Menadion/EggMinistrator/dashboard/assets-src/login page .png

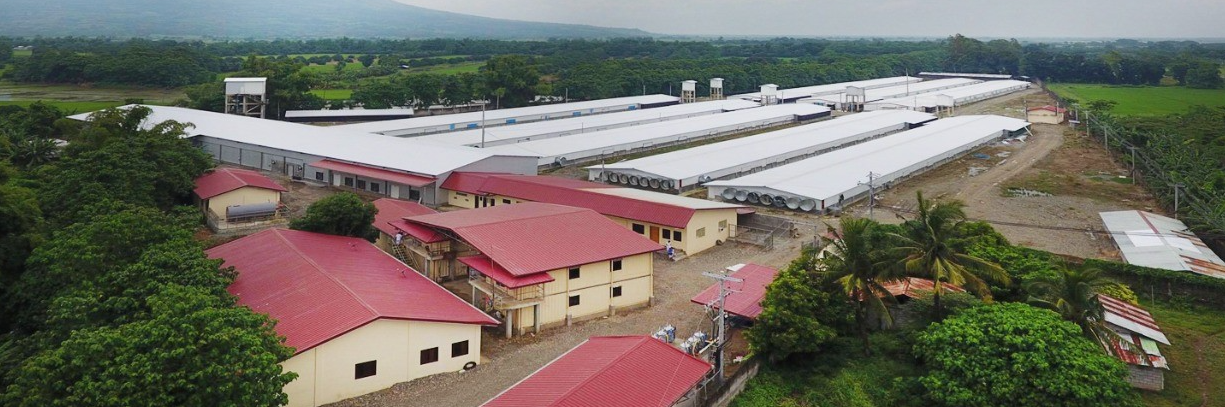
dashboard/assets-src/login page .png
