Menadion/EggMinistrator/firmware/EggMinistrator_ESP32/EggMinistrator_ESP32.ino

/*
  EggMinistrator -- ESP32 firmware (load cell + LCD + LEDs + buzzer only)

  BOARD: ESP32-D0WD-V3 rev v3.1, a CLASSIC ESP32. Confirmed 2026-08-20 by
  running firmware/board-id/ over COM3.

  RENAMED 2026-08-20. This was EggMinistrator_ESP32S3.ino, loose in firmware/.
  Two things were wrong with that. The chip is not an S3, and the Arduino IDE
  requires a .ino to sit inside a folder of the same name -- opening a loose
  sketch makes the IDE offer to move it into a new folder, and it moves ONLY
  the .ino, leaving secrets.h behind and breaking the #include. secrets.h now
  lives in this folder, beside the sketch, where the IDE cannot separate them.

  ⚠️ J: if you already made a secrets.h in firmware/, move it in here.
  ----------------------------------------------------------------------------
  This board does NOT handle the camera. The camera is a regular USB webcam
  plugged into the laptop, which runs ai/inference/classify.py. This board's
  only job is the physical side: read the load cell, send the weight to the
  server, and show whatever verdict comes back on the LCD / LEDs / buzzer.

  The display is a 16x2 character LCD on I2C, NOT the SSD1306 OLED this
  sketch originally targeted. Two lines of sixteen characters is the whole
  canvas -- there is no graphics library and no text sizing.

  THE WEIGHT LEAVES OVER WI-FI, NOT OVER THE USB CABLE. The USB cable
  carries power only, and this is not a style preference: hardware/
  bill-of-materials.md is explicit that a USB *data* path makes this board a
  peripheral attached to a computer, which contradicts the paper's title and
  section 2.2. You can run this board off a power bank across the room and
  it behaves identically. Do not "simplify" it back onto serial.

  NOT COMPILE-TESTED -- I don't have this hardware or an Arduino toolchain
  to verify it on. Grounded in current documentation for the pin
  restrictions and library APIs, but treat it as a first draft to debug on
  real hardware, the way you would any code from any source you haven't
  run yet.

  ============================================================================
  REQUIRED LIBRARIES (Arduino IDE > Sketch > Include Library > Manage
  Libraries):
    - "HX711 Arduino Library" by Bogdan Necula
    - "LiquidCrystal I2C" by Frank de Brabander
    - "ArduinoJson" by Benoit Blanchon (v6.x)
  WiFi.h and HTTPClient.h ship with the esp32 board package -- nothing to
  install. The two Adafruit libraries the OLED needed are no longer required.
  BOARD SELECTION -- GET THIS RIGHT OR THE UPLOAD FAILS:
    Tools > Board > ESP32 Arduino > "ESP32 Dev Module"
                                     ^^^^^^^^^^^^^^^^
    NOT "ESP32S3 Dev Module". This is a classic ESP32-D0WD-V3. Picking the S3
    entry compiles for the wrong chip and the upload will not take. Needs the
    "esp32" board package installed (Boards Manager > search esp32 > Espressif
    Systems).

    Port: Tools > Port > COM3 (that is where board-id found it).
    Everything else can stay on its default. If the upload stalls at
    "Connecting........", hold the BOOT button while it starts.

  ============================================================================
  BEFORE YOU FLASH -- four things, in this order. J, this list is for you.

  1. CHANGE NOTHING ON THE BOARD. Updated 2026-08-23: this sketch now uses
     YOUR pin map, copied from firmware/tester/tester.ino -- HX711 on 32/33,
     buzzer on 4, RGB module on 25 (red), 26 (green), 27 (blue). Your wiring
     is already correct and this step is now a no-op.

     This replaces the old instruction to move LEDs off GPIO12/13 onto
     26/27/23. That is obsolete; you already moved them.

     One rule survives: do NOT put anything back on GPIO12. It is MTDI, and
     if anything holds it HIGH at boot the chip selects a 1.8 V flash voltage
     and may not start at all.

  2. MAKE secrets.h. Copy secrets.h.example to secrets.h in this same folder
     and fill in all five values. It is gitignored, so it does not exist on a
     fresh clone and the sketch will not compile without it. SERVER_HOST is
     the LAN IP of the LAPTOP running the backend, not the board's own IP --
     `ipconfig` on Windows, the IPv4 Address line. DEVICE_KEY must match
     DEVICE_API_KEY in backend/.env exactly or every request comes back 401.
     Never put a real password in THIS file -- CONTRACT.md section 6.

  3. PICK THE RIGHT BOARD. See BOARD SELECTION above. "ESP32 Dev Module".

  4. EXPECT THE LCD TO BE BLANK THE FIRST TIME. LCD_I2C_ADDRESS below is set
     to 0x27, the common PCF8574 address, but a good share of these backpacks
     are 0x3F instead. A wrong address fails SILENTLY -- lit backlight, no
     characters. If that happens, change the one constant and reflash before
     assuming anything else is broken.

  Then: the serial monitor at 115200 is the fastest way to see what it is
  doing. It prints the Wi-Fi join, every weight it reads, and every HTTP
  status it gets back.

  ============================================================================
  PROTOCOL -- see CONTRACT.md section 4.1, which is the authority. Three
  calls, in order:

    1. POST /api/inspections                  { "weight_g": 58.23 }
       -> server creates the row, replies     { "id": 41 }

    2. (the laptop POSTs the classifier output against id 41 -- not us)

    3. GET  /api/inspections/41/result        polled every 500 ms
       -> { "status": "pending" }             until step 2 lands
       -> { "label": "good", "confidence": 0.83 }

    label is one of: good, defective, not_an_egg   (Decision G spelling)

  Every request carries an X-Device-Key header. This board cannot log in as
  a user, so that header is how the server knows it is us.

  Calibrate LOADCELL_CALIBRATION_FACTOR the same way regardless of which
  ESP32 board you use -- see the comment on that constant below.
*/

#include <HX711.h>
#include <Wire.h>
#include <LiquidCrystal_I2C.h>
#include <ArduinoJson.h>
#include <WiFi.h>
#include <HTTPClient.h>

#include "secrets.h"   // WIFI_SSID, WIFI_PASSWORD, SERVER_HOST, SERVER_PORT, DEVICE_KEY

// -----------------------------------------------------------------------
// Pins. REMAPPED 2026-08-15 for a CLASSIC ESP32, not the S3.
//
// The board is an ESP32-D0WD-V3, confirmed by reading it with
// firmware/board-id/board-id.ino rather than from the can, which is marked
// only "ESP32-32X" -- a reseller marking, not an Espressif part number.
//
// The earlier map was written for an ESP32-S3 and four of its pins were
// unusable here: on a classic ESP32, GPIO6 to GPIO11 are wired to the
// integrated SPI flash, and the LCD (8, 9), the buzzer (10) and the red LED
// (11) all sat in that range. Driving them crashes the chip. GPIO12 was also
// a poor choice -- it is MTDI, and held high at boot it selects a 1.8 V flash
// voltage and the board may not start at all.
//
// Avoided on this chip: GPIO6-11 (SPI flash), GPIO0/2/12/15 (strapping),
// GPIO1/3 (UART0, in use by the serial monitor), GPIO34-39 (input only, no
// output driver). GPIO16/17 are also skipped so that this map works unchanged
// on a WROVER module, where those two carry PSRAM.
// ⚠️ REMAPPED 2026-08-23 to match J's board, which is now soldered and cannot
// be changed before the defense. The map below is copied from his working
// bench sketch (firmware/tester/tester.ino), not chosen here.
//
// This SUPERSEDES the 2026-08-20 note that pinned HX711 to 4/5 "because J has
// that wired and reading correctly." That was true on the 20th. He re-wired
// since, and GPIO4 is now his buzzer -- so the old map would have driven the
// buzzer onto the load cell's data line. Confirmed with him directly before
// this edit rather than inferred from the file.
//
// The standing rule that produced the 4/5 entry still holds and produced this
// one too: verified hardware beats a tidier theory. Only the hardware moved.
#define HX711_DT_PIN  32
#define HX711_SCK_PIN 33
#define LCD_SDA_PIN   21   // the classic ESP32 I2C default pair, so stock
#define LCD_SCL_PIN   22   // wiring guides for this board apply as written
#define BUZZER_PIN     4

// 🔴 DESCOPED 2026-08-24, on the team's call, to get the hardware finished in
// time. No buzzer is fitted. Ver9.1's FR-15 asks for "a visual indicator and an
// on-station display", NOT an audible signal, so nothing in the paper is left
// unmet by this.
//
// The calls stay in place rather than being deleted, so wiring one later is a
// single edit here. But beep() BLOCKS: left running with no buzzer it spent
// 120-400 ms per egg waiting on a pin nothing is connected to, out of a 3 s
// per egg budget. Set true only when a buzzer is actually fitted.
#define HAS_BUZZER false
#define LED_RED_PIN   25
#define LED_GREEN_PIN 26
#define LED_BLUE_PIN  27   // WIRED BUT UNUSED since 2026-08-24 -- see indicateResult().
                           // Kept defined so it is still forced LOW at reset;
                           // otherwise a blue left lit by older firmware stays on.

// ✅ Each of the three verdicts keeps its own colour, so FR-15 is satisfied.
//
// FR-15 as Ver9.1 states it: "Indicate the classification result at the
// inspection station through a visual indicator and an on-station display."
// A visual indicator and a display. NOT an audible signal -- an older wording
// of FR-15 said that, and this repo tracked the old one for weeks. The LED and
// the 16x2 LCD satisfy it between them, which is why no buzzer is needed.
//
// ⚠️ CHANGED 2026-08-23: this is ONE RGB LED module on 25/26/27, not three
// discrete LEDs.
//
// ⚠️ CHANGED 2026-08-24: "not an egg" is ORANGE, not blue, on J's
// recommendation. The module has no orange pin -- pin 27 is never driven HIGH
// in either sketch -- so orange is RED full plus GREEN at partial brightness.
// The recipe is copied exactly from J's bench sketch (tester.ino:538-541,
// analogWrite(GREEN_LED, 80)), which is the version proven on the actual board.
// Full green instead of 80 gives yellow, not orange.
//
// GREEN is driven through analogWrite EVERYWHERE below, never digitalWrite.
// Mixing the two on one pin means analogWrite attaches an LEDC channel and a
// later digitalWrite may or may not detach it, depending on core version. One
// mode for that pin removes the question entirely. RED is never PWM'd, so it
// stays digitalWrite.

// The GPIO12/13 warning that stood here is retired: J's LEDs are no longer on
// those pins. Keeping the reason on record because it still constrains any
// future remap -- GPIO12 is MTDI, and held HIGH at boot it selects a 1.8 V
// flash voltage and the board may not start at all. Do not put anything back
// on 12.

// HX711 calibration factor -- MUST be calibrated for your specific load
// cell, the same procedure regardless of which ESP32 board drives it:
//   1. Flash a minimal sketch that prints scale.get_units(10) in a loop
//      with nothing on the platform, right after scale.tare().
//   2. Place a known weight (anything you can weigh precisely elsewhere)
//      and note the raw reading.
//   3. LOADCELL_CALIBRATION_FACTOR = raw_reading / known_weight_grams
//   4. Re-flash with that value; confirm get_units() reports correctly
//      for a couple of different test weights before trusting it.
// ✅ 2026-08-16, J: raw difference of 503206 - 458939 = 44267 counts for a
// known 60 g weight, giving 44267 / 60 = 737.8; he settled on 735.25 in
// testing, and an egg then read 58.6 g -- a plausible egg, not a coincidence.
//
// ⚠️ CHANGED 2026-08-23 to 698.0, taken from J's bench sketch
// (firmware/tester/tester.ino), on M's ruling that the station follows the
// number on the board J is actually running.
//
// The two numbers disagree by 5.3%, which is ~3 g on a 60 g egg -- THREE TIMES
// the 1 g tolerance (CONTRACT.md section 4, settled 2026-08-24 to match the
// paper's Table 9; the repo previously said +/-2 g, which made the same gap
// look like 1.5x). Only one of them can describe this assembly. 698.0 is
// adopted because it is the more recent of the two and the bench rig is the
// one physically wired, NOT because it was re-derived -- nobody has re-run the
// four steps above since the 16th.
//
// Tare matters as much as the factor at 1 g: tare(20) runs once in setup() and
// never again, so anything on the plate at power-up becomes zero for the whole
// session. Power up with the holder fitted and the plate empty.
//
// 🔴 OWED: re-run the calibration once the egg holder is final and delete the
// loser. The factor describes the whole mechanical assembly, not just the
// cell, so adding the holder invalidates both figures anyway.
float LOADCELL_CALIBRATION_FACTOR = 698.0;

const float EGG_PRESENT_THRESHOLD_G = 20.0;
const float EGG_REMOVED_THRESHOLD_G = 15.0;
const unsigned long WEIGHT_SEND_INTERVAL_MS = 300;

HX711 scale;

// 0x27 is the usual address for the PCF8574 backpack on these modules; a
// good number of them are 0x3F instead. If the screen stays blank but the
// backlight is on, that is the first thing to try. An I2C scanner sketch
// settles it in a minute.
#define LCD_I2C_ADDRESS 0x27
LiquidCrystal_I2C lcd(LCD_I2C_ADDRESS, 16, 2);

// Declared up here, before handleResult() and showResult() use it. It was
// originally defined further down the file, after its first use, which does
// not compile in C++ -- and the Arduino IDE's auto-generated prototypes make
// it worse, since they reference the type before it exists.
struct InspectionResultLocal {
  String label;
  float confidence;
};

unsigned long lastWeightSend = 0;
bool waitingForResult = false;
unsigned long resultRequestedAt = 0;
// RAISED 5000 -> 15000 on 2026-08-25. The old budget was shorter than the
// pipeline it was waiting on, so the board declared "No response" while the
// verdict was still in flight. It then landed in the database anyway, leaving
// the LCD and the dashboard disagreeing about the same egg. The board polls
// every 500 ms, so a longer ceiling costs nothing when the verdict is quick.
const unsigned long RESULT_TIMEOUT_MS = 15000;  // give up waiting and go back to idle

long currentInspectionId = -1;                  // handed back by step 1
unsigned long lastPoll = 0;
const unsigned long POLL_INTERVAL_MS = 500;

// A hard ceiling on the "wait for the operator to take the egg off" loop.
// Without it a drifting load cell or an egg nobody removes hangs the board
// forever with no way out but the reset button.
const unsigned long REMOVAL_TIMEOUT_MS = 30000;

// ---------------------------------------------------------------------------
String baseUrl() {
  return String("http://") + SERVER_HOST + ":" + String(SERVER_PORT);
}

// ---------------------------------------------------------------------------
// Bounded, so a wrong password shows an error instead of hanging in setup().
bool connectWifi(unsigned long timeoutMs) {
  if (WiFi.status() == WL_CONNECTED) return true;

  WiFi.mode(WIFI_STA);
  WiFi.begin(WIFI_SSID, WIFI_PASSWORD);

  unsigned long start = millis();
  while (WiFi.status() != WL_CONNECTED && millis() - start < timeoutMs) {
    delay(250);
  }
  return WiFi.status() == WL_CONNECTED;
}

// ---------------------------------------------------------------------------
void setup() {
  Serial.begin(115200);   // kept for debugging and load cell calibration only
  pinMode(BUZZER_PIN, OUTPUT);
  pinMode(LED_RED_PIN, OUTPUT);
  pinMode(LED_GREEN_PIN, OUTPUT);
  pinMode(LED_BLUE_PIN, OUTPUT);
  digitalWrite(BUZZER_PIN, LOW);
  digitalWrite(LED_RED_PIN, LOW);
  analogWrite(LED_GREEN_PIN, 0);   // one mode for this pin, everywhere
  digitalWrite(LED_BLUE_PIN, LOW);

  Wire.begin(LCD_SDA_PIN, LCD_SCL_PIN);
  // Unlike the OLED's begin(), LiquidCrystal_I2C::init() reports nothing back,
  // so a wrong address fails silently -- blank screen, lit backlight. See the
  // note on LCD_I2C_ADDRESS above.
  lcd.init();
  lcd.backlight();
  showMessage("Starting...");

  showMessage("Connecting WiFi");
  if (connectWifi(20000)) {
    Serial.print("Wi-Fi connected, IP ");
    Serial.println(WiFi.localIP());
  } else {
    Serial.println("Wi-Fi FAILED -- check secrets.h");
    showMessage("WiFi failed\nCheck secrets.h");
    beepError();
  }

  scale.begin(HX711_DT_PIN, HX711_SCK_PIN);

  // Taken from J's bench sketch, and it fixes a real defect here. tare() calls
  // wait_ready() internally, which spins until the HX711's DOUT pin goes low.
  // With the amplifier unwired or on the wrong pins that never happens and
  // setup() hangs forever -- no serial past this point, no HTTP, nothing. It
  // reads as a dead board rather than a wiring fault. Ask first, with a bound.
  if (!scale.wait_ready_timeout(3000)) {
    Serial.println("ERROR: HX711 not responding -- check DT/SCK wiring and power");
    showMessage("HX711 error\nCheck wiring");
    beepError();
    // Deliberately does not continue. Every weight from here would be garbage,
    // and a station silently reporting nonsense is worse than one that stops.
    while (true) delay(1000);
  }

  scale.set_scale(LOADCELL_CALIBRATION_FACTOR);

  showMessage("Taring...\nEmpty the plate");
  delay(2000);      // give the operator a moment to take anything off
  scale.tare(20);   // 20 readings rather than the default; steadier zero

  showMessage("Ready.\nPlace an egg.");
}

// ---------------------------------------------------------------------------
float readWeightGrams() {
  if (!scale.is_ready()) return 0.0;
  return scale.get_units(5);
}

// ---------------------------------------------------------------------------
// The weight that actually gets sent. A single get_units() reading taken the
// instant an egg lands is still settling, so this waits for the mechanical
// bounce to die down and then averages. From J's bench sketch, where it was
// the difference between a stable number and one that drifted a gram either
// way while you watched it.
float settledWeightGrams() {
  delay(800);   // let the egg stop rocking before measuring anything

  const int readings = 20;
  float total = 0;
  for (int i = 0; i < readings; i++) {
    float grams = scale.get_units(1);
    if (grams < 0) grams = 0;   // a hair below zero is noise, not a negative egg
    total += grams;
    delay(30);
  }
  return total / readings;
}

// ---------------------------------------------------------------------------
// ⚠️ TEMPORARY, AND IT IS A SECOND COPY OF SOMETHING THE SERVER OWNS.
//
// Size grading belongs to the server: CONTRACT decision 4, implemented by
// findSizeGrade() against the size_grades table. This exists only so the board
// can show something useful on the LCD while running standalone on the bench,
// before the laptop half of section 4.1 exists.
//
// DELETE THIS the moment the board is getting real verdicts back from the
// server. Two copies of a grading rule is two rules, and the one on the LCD
// will eventually disagree with the one on the dashboard in front of somebody.
//
// The bands are PNS/BAFS 321:2021, matching database/sample-data.sql exactly.
// J's bench sketch used the USDA sizes instead (Small 42.52, Medium 49.61,
// Large 56.70, X-Large 63.79, Jumbo 70.87), which is a different national
// standard: a 58.6 g egg is Medium under PNS and Large under USDA. The paper
// cites PNS, so PNS wins here.
String localSizeGrade(float grams) {
  if (grams <  45.0) return "Pewee";
  if (grams <  55.0) return "Small";
  if (grams <  60.0) return "Medium";
  if (grams <  65.0) return "Large";
  if (grams <  70.0) return "Extra Large";
  return "Jumbo";
}

// ---------------------------------------------------------------------------
// Step 1. Returns true and sets currentInspectionId, or false on any failure.
bool postWeight(float grams) {
  if (!connectWifi(5000)) return false;

  HTTPClient http;
  http.begin(baseUrl() + "/api/inspections");
  http.addHeader("Content-Type", "application/json");
  http.addHeader("X-Device-Key", DEVICE_KEY);

  StaticJsonDocument<96> body;
  body["weight_g"] = grams;
  String payload;
  serializeJson(body, payload);

  int code = http.POST(payload);
  if (code != 200 && code != 201) {
    Serial.print("POST /api/inspections failed, HTTP ");
    Serial.println(code);
    http.end();
    return false;
  }

  StaticJsonDocument<128> reply;
  DeserializationError err = deserializeJson(reply, http.getString());
  http.end();
  if (err || !reply.containsKey("id")) {
    Serial.println("POST /api/inspections: no id in reply");
    return false;
  }

  currentInspectionId = reply["id"].as<long>();
  Serial.print("inspection id ");
  Serial.println(currentInspectionId);
  return true;
}

// ---------------------------------------------------------------------------
// Step 3. Asks once. Returns true only when a real verdict came back.
bool pollForResult(InspectionResultLocal &out) {
  if (currentInspectionId < 0) return false;
  if (WiFi.status() != WL_CONNECTED) return false;

  HTTPClient http;
  http.begin(baseUrl() + "/api/inspections/" + String(currentInspectionId) + "/result");
  http.addHeader("X-Device-Key", DEVICE_KEY);

  int code = http.GET();
  if (code != 200) {
    http.end();
    return false;
  }

  StaticJsonDocument<192> reply;
  DeserializationError err = deserializeJson(reply, http.getString());
  http.end();
  if (err) return false;

  // Still waiting on the laptop's classification -- not an error.
  if (!reply.containsKey("label")) return false;

  out.label = reply["label"].as<String>();
  out.confidence = reply["confidence"] | 0.0f;
  return true;
}

// ---------------------------------------------------------------------------
// Bounded wait for the operator to lift the egg off the platform. Bails out
// after REMOVAL_TIMEOUT_MS rather than blocking the board indefinitely.
void waitForEggRemoval() {
  unsigned long start = millis();
  while (readWeightGrams() > EGG_REMOVED_THRESHOLD_G) {
    if (millis() - start > REMOVAL_TIMEOUT_MS) {
      Serial.println("egg never removed -- giving up and re-arming");
      break;
    }
    delay(200);
  }
  digitalWrite(LED_RED_PIN, LOW);
  analogWrite(LED_GREEN_PIN, 0);   // NOT digitalWrite -- see indicateResult()
  digitalWrite(LED_BLUE_PIN, LOW);
  showMessage("Ready.\nPlace an egg.");
}

// ---------------------------------------------------------------------------
void handleResult(const InspectionResultLocal &result) {
  showResult(result);
  indicateResult(result);
  waitingForResult = false;
  currentInspectionId = -1;
  waitForEggRemoval();
}

// ---------------------------------------------------------------------------
void loop() {
  float weight = readWeightGrams();
  unsigned long now = millis();

  if (waitingForResult) {
    if (now - resultRequestedAt > RESULT_TIMEOUT_MS) {
      // The server never produced a verdict (laptop app not running? egg not
      // detected in frame?) -- don't leave the operator staring at a stale
      // "Sending weight" forever.
      showMessage("No response.\nTry again.");
      beepError();
      waitingForResult = false;
      currentInspectionId = -1;
      return;
    }

    if (now - lastPoll > POLL_INTERVAL_MS) {
      lastPoll = now;
      InspectionResultLocal result;
      if (pollForResult(result)) {
        handleResult(result);
      }
    }
    return;   // don't send more weight readings mid-inspection
  }

  if (weight < EGG_PRESENT_THRESHOLD_G) {
    delay(150);
    return;   // nothing on the platform yet
  }

  // An egg just showed up: settle, measure properly, then send.
  if (now - lastWeightSend > WEIGHT_SEND_INTERVAL_MS) {
    showMessage("Egg detected.\nMeasuring...");
    lastWeightSend = now;

    // The trigger reading above only had to clear a 20 g threshold. It is not
    // the measurement -- the egg is still settling when it crosses that line.
    // This is the number that goes in the database and drives the size grade,
    // so it is worth the extra second.
    float finalWeight = settledWeightGrams();

    // Bench aid only: shows a grade before the server has answered. Goes away
    // with localSizeGrade() once the laptop half of section 4.1 exists.
    Serial.print("Final weight: ");
    Serial.print(finalWeight, 2);
    Serial.print(" g, local grade ");
    Serial.println(localSizeGrade(finalWeight));

    showMessage("Sending weight");

    if (postWeight(finalWeight)) {
      waitingForResult = true;
      resultRequestedAt = now;
      lastPoll = now;
    } else {
      showMessage("Server error\nTry again.");
      beepError();
    }
  }
}

// ---------------------------------------------------------------------------
// Every message is at most two lines of sixteen characters. Call sites keep
// the original "\n" convention and this splits on it, so the message strings
// elsewhere in the file did not have to change.
//
// Anything past column 16 is CUT, not wrapped. A character LCD wraps a long
// line onto whichever row it feels like -- on many 16x2 modules row 0
// continues into row 2 of a 4-line address space, which shows up as nothing
// at all. Truncating is ugly on purpose; silent disappearance is worse.
void showMessage(const String &msg) {
  int split = msg.indexOf('\n');
  String top    = (split < 0) ? msg : msg.substring(0, split);
  String bottom = (split < 0) ? ""  : msg.substring(split + 1);

  lcd.clear();
  lcd.setCursor(0, 0);
  lcd.print(top.substring(0, 16));
  lcd.setCursor(0, 1);
  lcd.print(bottom.substring(0, 16));
}

// Verdict on the top row, confidence underneath. The longest label we can
// receive is "not_an_egg" at 10 characters, so it fits without truncating.
void showResult(const InspectionResultLocal &result) {
  lcd.clear();
  lcd.setCursor(0, 0);
  lcd.print(result.label.substring(0, 16));
  lcd.setCursor(0, 1);
  lcd.print("Conf: ");
  lcd.print(result.confidence * 100.0, 0);
  lcd.print("%");
}

// ---------------------------------------------------------------------------
// FR-15: "Indicate the classification result at the inspection station
// through a visual indicator and an on-station display." (Ver9.1 wording. An
// earlier version said "an audible signal", which is why beep() exists below.)
void indicateResult(const InspectionResultLocal &result) {
  digitalWrite(LED_RED_PIN, LOW);
  analogWrite(LED_GREEN_PIN, 0);
  digitalWrite(LED_BLUE_PIN, LOW);

  if (result.label == "good") {
    analogWrite(LED_GREEN_PIN, 255);
    beep(1, 120);
  } else if (result.label == "defective") {
    digitalWrite(LED_RED_PIN, HIGH);
    beep(2, 120);
  } else {
    // "not an egg" -- ORANGE: red full, green partial. Same values as J's
    // bench sketch. Steady rather than blinking, so it reads as a verdict
    // rather than as an error state.
    digitalWrite(LED_RED_PIN, HIGH);
    analogWrite(LED_GREEN_PIN, 80);
    beep(3, 80);
  }
}

void beep(int times, int durationMs) {
  if (!HAS_BUZZER) return;   // no buzzer fitted: do not burn the delay
  for (int i = 0; i < times; i++) {
    digitalWrite(BUZZER_PIN, HIGH);
    delay(durationMs);
    digitalWrite(BUZZER_PIN, LOW);
    if (i < times - 1) delay(durationMs);
  }
}

void beepError() {
  if (!HAS_BUZZER) return;
  digitalWrite(BUZZER_PIN, HIGH);
  delay(500);
  digitalWrite(BUZZER_PIN, LOW);
}
