Menadion/EggMinistrator/(commit log)

2026-07-27 docs: sync READMEs to the single-candling design, add BOM
    The READMEs were written in the initial scaffold, before the group meeting
    settled the capture on one candling frame. They still described a two-photo
    rig and promised dirt/discoloration detection the system cannot do.
    - README: one capture, three kinds of finding (quality / shell / balut routing)
    - ai: dataset classes no longer list dirty/discolored; note that no dataset is
    inherited; single-model accuracy field
    - firmware: document that the ESP32-CAM has no USB port and needs an FTDI or
    ESP32-CAM-MB to flash at all
    - hardware: two-wave purchase plan; enclosure is a commissioned 3D print, with
    what a print shop needs from us
    -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
2026-07-28 docs: align repo docs with Ver4 (balut descoped), flag stack mismatch
    Ver4 removed balut/embryo routing from both scope sections. Strip it from
    the repo docs and pin the AI class list to what Ver4 s3.2.6 actually names.
    - README.md: drop the Routing row; two kinds of finding, not three.
    - ai/README.md: no embryo class. Dataset classes pinned to s3.2.6 wording
    (good, blood-meat-spot, large-crack, gross-shell-damage).
    - CONTRIBUTING.md: scope note updated; dashboard verification is now
    npm run build, not php -l.
    Also flags an unresolved contradiction the merge exposed: the paper says
    the dashboard is PHP + XAMPP, the merged dashboard/ is React + Vite with
    no PHP. Noted in README.md and C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
2026-07-28 docs: add FR-04 size classification spec (PNS/BAFS 321:2021)
    FR-04 said "assign a size class based on measured weight" with no table
    behind it. sample-data.sql implemented 5 grades with invented boundaries;
    mockData.js implemented 6 with different ones. Neither matched a standard.
    Pins the grades to PNS/BAFS 321:2021 and gives Ricardo the replacement
    seed data plus the lookup query. Boundaries restated as half-open ranges
    so decimal load-cell readings can't fall between two classes.
    Flags three items still to verify against the standard itself: whether it
    defines six classes or seven (the seventh is likely duck), the "Pewee"
    spelling, and the whole-gram band phrasing.
2026-07-28 docs: settle dashboard stack in favour of React, update BOM
    Decision E: the paper is corrected to name React + Vite rather than
    rebuilding the dashboard in PHP 13 days out. MySQL and XAMPP stay.
    - README.md, CONTRIBUTING.md: unresolved-contradiction warnings replaced
    with the decision and its rationale.
    - bill-of-materials.md: "already owned" row split so PHP no longer
    appears as the stack. Zero-cost claim is unaffected since Node, React
    and Vite are free as well.
2026-07-30 docs: pin the classifier output spec, fix BOM stack, supersede DIRTY
    The paper settled the classifier's output on 2026-07-30 (Decision G): the model
    emits three classes, good / defective / not_an_egg. It returns one verdict per
    egg and does not report which defect it found.
    ai/README.md: the class list was an unfilled comment blocking the labelling
    protocol and the database schema. Now specified, with the reasoning. Softmax
    scores sum to 1, so a per-defect list cannot represent an egg with two defects
    at once; more decisively, blood and meat spots cannot be sourced on demand, so
    splitting the scarcest images across several classes is the worst option
    available to this dataset. not_an_egg is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
2026-08-02 feat(ai): open and resize the image, guard the failure path
    classify.py now reads the file it was named after, forces it to a fixed
    224x224, and still emits the unchanged three-field contract.
    cv2.imread returns None on an unreadable path rather than raising, so the
    failure surfaced one line later at resize with an assertion error that
    mentions nothing about files. The guard catches it at the point it happens
    and exits nonzero with the path on stderr, printing no JSON line.
    A missing file is not a not_an_egg. That class is a verdict about what the
    camera saw; an unreadable path means nothing was observed at all. Emitting
    one would write a false observation into ai_assessments, corrupt the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
2026-08-06 feat(ai): train a real model from the dataset folders
    train.py reads ai/dataset/, holds back 20% for validation, and fits a
    2,562-parameter head on a frozen MobileNetV2 base. It saves egg.keras
    and classes.json from the same run, so the class order travels with the
    weights it describes.
    Keras assigns class indices alphabetically, which means adding a folder
    silently renumbers the classes already there. Nothing hardcodes the
    list; check_order.py prints the order Keras actually assigned.
2026-08-06 feat(ai): classify from the trained model instead of a hardcoded verdict
    classify.py loads egg.keras and classes.json, runs the image through the
    model, and reports the winning class with its score. The class list is
    read from disk rather than restated in the source, so it cannot drift
    away from the model that produced it.
    Converts BGR to RGB before predicting. cv2.imread returns BGR while
    image_dataset_from_directory reads RGB, so training and inference
    disagreed on channel order and nothing raised an error. On the sample
    image the correction moved confidence from 0.58 to 0.74.
2026-08-09 feat(ai): track the dataset class folders, add the collection guide
    The three class folders under ai/dataset/ are now committed empty via .gitkeep, so
    anyone who clones gets the exact class names. The folder name IS the class string that
    train.py reads and classify.py prints, so a typo or a rename silently changes what the
    system reports. Tracking the folders removes the chance to get it wrong.
    .gitignore now ignores dataset contents rather than the dataset folder itself. The
    negations come last because the last matching rule wins.
    Adds how-to-add-images.md, the shooting and training guide for whoever collects photos,
    and requirements.txt pinned to the versions the model was trained with.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
2026-08-09 docs: propagate the hardware descope and sync the docs with shipped code
    Two sets of changes, both catching the documentation up to reality.
    The 2026-08-07 hardware descope: the ESP32-CAM is out of the build. Capture is a USB
    webcam on the laptop and the already-owned ESP32-S3 is repurposed from programmer to
    networked weight node, reading the HX711 and posting over Wi-Fi. That Wi-Fi hop is what
    keeps the IoT claim in the paper title true, so firmware/README.md now says explicitly
    not to wire it over USB serial instead. bill-of-materials.md is rebuilt around the new
    parts list with real figures. Shell colour corrected to white and tinted throughout;
    brown was never sourced.
    ai/README.md ha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
2026-08-13 feat(ai): stamp the model version at training time
    model_version is NOT NULL on main since the merge, and classify.py emitted
    only three fields, so no assessment row could be inserted at all.
    train.py now writes ai/models/version.json in the same run that saves the
    weights, as MODEL_VERSION plus a UTC stamp (0.3.0+20260813T144500Z). Written
    alongside model.save() on purpose: a version typed by hand is a sticker you
    can forget to peel off, and the database would record a string describing
    weights nobody has. Same reasoning as classes.json.
    classify.py reads it, times the prediction, and emits six fields instead of
    three: +model_name, +model_version, +inference_time_ms.
    version.json is giti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
2026-08-13 docs: settle not_an_egg, record the merge
    Decision 8: a not_an_egg scan is recorded, not discarded. Misload rate is
    real diagnostic data about the station. The proposal to write nothing and
    only warn on screen is declined.
    The flood behind that proposal was real but is already fixed at the source:
    inspectionService.js:33 filters final_disposition <> no_egg, that endpoint is
    the only path any page has to inspection rows, and the schema.sql:202 view
    filters the same way. Misload rows are write-only. A UI guard written for
    this was reverted the same day - it guarded a door the SQL already locks.
    Records the open consequence: AnalyticsPage.jsx:134 counts not_an_egg from
    rows the API already st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
2026-08-13 fix(dashboard): recompute the history filter when the fetch lands
    useMemo was missing historyScans from its dependency array, so filtered was
    computed once against the empty starting array and never recalculated when
    the request returned. History sat on "No inspections match your filters"
    until you touched a dropdown.
    Found while investigating the misload flood; unrelated to it.
2026-08-13 docs: settle raw_result, store the classifier's line verbatim
    raw_result holds the full JSON line classify.py printed, stored character for
    character. Not a re-serialised copy: parsing and re-dumping reorders keys and
    changes spacing, and the value of the column is that it is the classifier's
    own output rather than a version of it.
    Every other column in ai_assessments is written by the insert code.
    raw_result is the only value in the row that arrives untouched, so when a
    stored result looks wrong it answers whether the model said it or the insert
    changed it, without re-running the pipeline. The six emitted fields also land
    in two tables - five columns in ai_assessments, image in inspection_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
2026-08-13 feat(firmware): take J's ESP32-S3 sketch, fix the type-before-use error
    Written by J, cherry-picked from origin/Jasfer 23a449a. It was sitting in
    hardware/Pyhton yolo/ alongside a parallel YOLO pipeline; only this file
    comes across, and it lands in firmware/ where section 2 says ESP32 firmware
    belongs. Nothing else from that branch is taken - see CONTRACT.md section 7.
    Why this file and not the rest: it is the only one that matches the current
    design. No camera on the board, USB webcam on the laptop, and three result
    states including not_an_egg, so it agrees with settled decision 8. The
    branch's data.yaml classifies good / cracked-damaged / blood-meat-spot,
    which result_label cannot store.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
    [EggMinistrator_ESP32S3.ino]
2026-08-13 docs: specify the station-to-server seam, close the last TO FILL
    Section 4.1 still described the ESP32 sending a candling image, which was
    the ESP32-CAM design. Since the 2026-08-07 descope the board sends weight
    only; the camera is a USB webcam on the laptop.
    Transport is HTTP over Wi-Fi. The board's USB cable carries power, not data:
    bill-of-materials.md is explicit that a USB data path makes the board a
    peripheral attached to a computer, which contradicts the paper's title and
    section 2.2.
    Three calls, in order. The board POSTs weight and the server mints the
    egg_inspections row and returns its id; the laptop POSTs the six classifier
    fields against that id; the board polls for the verdi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
2026-08-13 feat(firmware): drive the 16x2 LCD instead of the SSD1306 OLED
    The station display is a pre-owned 16x2 I2C character LCD, confirmed by J on
    2026-08-13. The sketch targeted a 128x64 SSD1306, so this is a library and an
    API change, not a rename: Adafruit_SSD1306 and Adafruit_GFX are dropped for
    LiquidCrystal_I2C, and there is no graphics context, no text sizing and no
    pixel cursor to work with.
    showMessage() keeps the original "\n" convention and splits on it, so every
    call site elsewhere in the file is unchanged. It truncates at column 16 by
    design: a character LCD given a too-long line wraps it into whichever row the
    controller's address map says comes next, which on many 16x2 modules is no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
2026-08-13 feat(firmware): post weight over Wi-Fi, add a stub server to test against
    Implements the three calls in CONTRACT.md section 4.1. The board POSTs its
    weight, the server mints the egg_inspections row and returns the id, and the
    board polls that id every 500ms until a verdict exists, then drives the LCD,
    LEDs and buzzer per FR-15.
    The USB cable now carries power only. bill-of-materials.md is explicit that a
    USB data path makes this board a peripheral attached to a computer, which
    contradicts the paper's title and section 2.2, so the sketch says so at the
    top where someone tempted to simplify it back to serial will read it.
    readSerialCommands() and handleLine() are gone with the serial protoco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
    [EggMinistrator_ESP32S3.ino, stub_server.py]
2026-08-13 fix(backend): override writes final_disposition, not final_grade (FR-03 verified)
    [stub_server.py]
2026-08-13 docs: pin the owed paper revisions, correct the dataset collection constraint
2026-08-14 docs: load cell and HX711 arrived, calibration is the next hardware job
2026-08-15 feat(backend): open a daily batch so station rows get readable egg IDs
    createInspection left batch_id and sequence_number null, so formatEggId fell
    back to a truncated UUID and every station-created row read as 78919cdf...
    next to the seeded B001-EGG-001 rows.
    A batch is now one day's inspection run at one station. The first egg of the
    day opens it, the rest join it, and sequence_number restarts at 1 each day.
    Chosen over an operator-started batch because the station has no screen to
    open and close one by hand; explicit sessions stay as future work, which is
    what started_at and completed_at were designed for.
    Two details that are load-bearing rather than stylistic:
    - The date comes from C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
2026-08-15 fix(firmware): remap pins for a classic ESP32, four sat on the flash bus
    The board is an ESP32-D0WD-V3, not an ESP32-S3. Confirmed by reading the chip
    rather than the can, which carries only "ESP32-32X" -- a reseller marking with
    no Espressif part behind it.
    The pin map was written for an S3 and was unsafe here. On a classic ESP32
    GPIO6 to GPIO11 are wired to the integrated SPI flash, and the LCD (8, 9),
    the buzzer (10) and the red LED (11) all sat inside that range; driving them
    crashes the chip. GPIO12 was also poor -- it is MTDI, and held high at boot it
    selects 1.8 V flash and the board may not start.
    HX711 DT 4 -> 32 buzzer 10 -> 25
    HX711 SCK 5 -> 33 LED red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
    [EggMinistrator_ESP32S3.ino, board-id.ino]
2026-08-16 feat(firmware): adopt J's verified hardware layer, keep the network architecture
    J's bench sketch is the ground truth for what actually works on the board, so
    the hardware half comes from it wholesale. The architecture does not.
    Taken from his file:
    - HX711 back on pins 4/5. An earlier pass moved them to 32/33 on paper;
    his is wired and reading correctly, and both pins are fine on a classic
    ESP32. Verified hardware beats a tidier theory.
    - Calibration factor 735.25, measured against a known 60 g weight. Replaces
    the library placeholder 2280.0, which made every reading meaningless.
    - wait_ready_timeout(3000) before tare, which fixes a real defect here:
    tare() spins fore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
    [EggMinistrator_ESP32S3.ino]
2026-08-18 fix(database): staff_overrides accepts no_egg (audit item 1)
    previous_disposition and new_disposition carried three values while
    egg_inspections has carried four since Decision G. An inspector correcting a
    wrong no_egg verdict had no legal value for the state being corrected away
    from, so the override row could not insert.
    Both columns widened, not just previous_disposition: staff may also need to
    mark a capture as containing no egg when the model got it the other way round.
    Latent, not live -- overrideInspection() writes egg_inspections and has never
    inserted into staff_overrides. Wiring that up is a separate question; the
    schema can now accept the write.
2026-08-18 docs(contract): staff_overrides is not empty, it holds one seeded row
    Correcting item 7 against the live local database. sample-data.sql:50 seeds a
    single override row dated 2026-07-25, so the table is not empty -- and the
    seeded row is the sharper problem. An empty table reads as "not built yet".
    One plausible hand-written row reads as working until someone checks that the
    count does not move when you override an egg on the projector.
    No application code path writes the table; that part stands.
2026-08-20 feat(firmware): enable the third LED, and pin down the real board
    J found a third LED on the bench, so HAS_BLUE_LED goes true and each of the
    three verdicts gets its own colour. CONTRACT and the paper already said three;
    they were right.
    The README's status block was still "not written yet" and is now accurate:
    535 lines, calibrated 2026-08-16 at 735.25, never compiled, never flashed.
    board-id was run on COM3 and the board answered ESP32-D0WD-V3 rev v3.1, MAC
    1c:69:20:a3:f8:8c. That is a CLASSIC ESP32, not an S3. The can says only
    "ESP32-32X", a reseller marking, which is why it had to be asked. The sketch's
    pin map was already rewritten for this chip and avoids the SPI-flash, strapping
    an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
    [EggMinistrator_ESP32S3.ino]
2026-08-20 docs(contract): reverse the weight descope, record the adviser rulings
    The 2026-08-19 weight descope lasted 24 hours. The adviser declined the title
    change on 2026-08-20, and a locked title naming "Load Cell Weight Measurement"
    means the component has to exist. The load cell and HX711 are back in the
    build; both arrived 2026-08-14 and never left the shelf, no size-grading code
    was deleted, and R was never told. FR-04 and FR-13 return, the count goes back
    to 8 of 15, and the BOM matches the paper's Table 2 again at 3,432.00.
    Three further rulings recorded, all reaching past the descope:
    - the defense requires PHYSICAL HARDWARE; a simulator will not be accepted.
    This overrules the 2026-08-1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
2026-08-20 feat(ai): add zoom to capture.py so the egg fills the frame
    The webcam sees the whole chamber; only the egg is worth training on. +/- give
    a centre crop from 1.0x to 4.0x, 0 resets, and the CROP is what gets saved, not
    just what is previewed. The window scales it back up so it stays a usable
    viewfinder while the file on disk keeps the crop's real pixels.
    Framing has to be identical across the dataset or the model learns that scale
    is meaningless, so --zoom starts a session at a fixed value and the setting is
    stamped into every filename as z18. A batch shot at the wrong zoom can then be
    found and pulled instead of quietly poisoning a training run.
    The overlay warns TOO FAR IN below 224x224,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
2026-08-20 docs(firmware): make the sketch flashable by J, record the board-id result
    Comment-only changes to the sketch; no pin or logic changes.
    The board-selection line said to pick "ESP32S3 Dev Module". That is the wrong
    chip and the upload would not have taken. It now says "ESP32 Dev Module", with
    the port and the BOOT-button fallback.
    BEFORE YOU FLASH is now a four-step checklist aimed at J: move the LEDs off
    GPIO12/13 to the 26/27/23 the sketch drives (12 is MTDI and a boot hazard),
    create secrets.h from the example, pick the right board, and expect a blank
    LCD if the backpack is 0x3F rather than 0x27.
    board-id.ino now carries its own result at the top -- ESP32-D0WD-V3 rev v3.1,
    MAC 1c:69:20: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
    [EggMinistrator_ESP32S3.ino, board-id.ino]
2026-08-20 docs(contract): park the dashboard polling and audible cue as pending work
    Both wait on working hardware. Recorded so they are not forgotten, not so
    they are started now.
    The dashboard fetches once on mount and never polls, which was fine when the
    demo was a simulator batch and is not fine now that the adviser requires live
    hardware with eggs placed one at a time. FR-15's audible half has nowhere to
    live either: the laptop speaker was ruled acceptable, but no audio exists in
    dashboard/ or backend/, and the firmware's beep() drives a pin with no buzzer
    on it. One poll fixes both. Browser autoplay is the trap.
2026-08-20 refactor(firmware): rename the sketch to EggMinistrator_ESP32 and give it a folder
    The name said S3. The board is an ESP32-D0WD-V3, a classic ESP32, so the name
    was wrong. The paper says only "ESP32" throughout, which is what this now
    matches.
    Moved into firmware/EggMinistrator_ESP32/ rather than renamed in place, because
    the loose layout was already a trap. The Arduino IDE requires a .ino to sit in
    a folder of the same name; opening a loose sketch makes the IDE offer to create
    one, and it moves ONLY the .ino, leaving secrets.h behind and breaking the
    #include. secrets.h.example moves with the sketch so the IDE cannot separate
    them. board-id/ already had this right.
    .gitignore now matches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
    [EggMinistrator_ESP32.ino, board-id.ino, simulate_station.py]
2026-08-20 docs(contract): defective class is cracks alone, and the candler is a single point of failure
    Air-cell ageing is out: the station sits at the laying house at pickup, so
    every egg is hours old and the air cell has not developed. It is not present
    in the population, so training on artificially aged eggs would teach a class
    that never appears at inference. Blood and meat spots are out too -- the client
    confirmed 2026-08-20 that they do not grade for them at all.
    FR-12's internal-quality claim narrows with it. The station does not read the
    contents of an egg; it shows hairline cracks the naked eye misses at pickup.
    Also recorded: there is one candler and it is J's, so the whole AI track is
    que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
2026-08-20 docs(contract): the dataset is serial behind the chamber, not parallel with it
    Training images have to come from the same environment the model runs in --
    same candler, same chamber, same seal, same distance. That makes collection
    strictly downstream of the rig existing, so it cannot run alongside the
    hardware work the way this file implied.
    Rejects the second-candler idea from earlier today: a candler is not a rig,
    images shot anywhere else are unusable, and shipping would land after the
    bottleneck cleared.
    What does recover the parallelism is splitting the hardware in two. The
    optical chamber blocks the dataset; the electronics do not. Build and FREEZE
    the chamber first, then shooting an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
2026-08-21 feat(ai): add the capture listener, the missing middle of the pipeline
    The board could weigh an egg and the model could classify a file on disk, but
    nothing connected the two, so no inspection ever got a verdict. FR-01 and FR-11
    have been red for this reason. This is steps 2 to 4 of the architecture figure.
    Long-running by necessity: TensorFlow load and camera open are seconds each, and
    the paper targets three seconds per egg, so the model stays resident and the
    camera stays open. Spawning per egg cannot hit the target.
    Two things that look like model faults but are not, handled here:
    - a webcam returns the frame it captured last, which can be seconds stale, so
    four frames are discarded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
2026-08-21 fix(ai): open high-resolution webcams that the default backend refuses
    J's 4K EMEET C60E would not open. On Windows OpenCV defaults to Media
    Foundation, which often fails or hangs for ten-plus seconds on high-resolution
    UVC cameras. open_camera() now tries the default, then retries with DirectShow
    and says which one worked. Nothing changes where the default already works.
    Shared between capture.py and listen_station.py rather than copied, same as
    crop_to_zoom, so the two cannot drift.
    The failure message now names the three real causes instead of guessing at one:
    wrong camera index, another app holding the device, or Windows blocking desktop
    apps from the camera.
    Also shows the negotiated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
2026-08-22 docs(readme): the client ruled out spots, and the board is not an S3
    Six READMEs had drifted from the paper, the code and two rulings.
    - blood/meat spots and air cell removed as capabilities. The client
    confirmed 2026-08-20 they do not grade for spots at all, so "internal
    quality" is cracks revealed by transillumination and nothing else.
    Ver9's FR-14 already said so. Replaced the two-kinds-of-finding table
    with the three verdicts the model actually emits.
    - ai/README's "why three classes" argument rested on spots being
    unsourceable. Rebuilt on pooling, which stands without them, and
    recorded that cracks are the one defect the team can manufacture.
    - dashboard/README claimed mock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
2026-08-23 fix(firmware): follow J's board, the pins moved and so did the factor
    J's wiring is soldered and cannot change before the defense, so the station
    sketch adapts to it rather than the other way round. Pin map copied from his
    working bench sketch, now committed as firmware/tester/tester.ino.
    HX711 DT 4 -> 32 buzzer 25 -> 4
    HX711 SCK 5 -> 33 red 26 -> 25
    LCD SDA/SCL 21/22 unchanged
    green 27 -> 26
    blue 23 -> 27
    The 2026-08-20 note pinning HX711 to 4/5 "because J has that wired" was true
    when written; he re-wired since, and GPIO4 is now his buzzer. The old map
    would have driven the buzzer onto the load cell's da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
    [EggMinistrator_ESP32.ino, tester.ino]
2026-08-23 docs(firmware): step 1 said move the LEDs, there is nothing left to move
    The BEFORE YOU FLASH list still told J to move his LEDs off GPIO12/13 onto
    26/27/23. Both halves are dead: he already moved them, and the sketch now
    follows his 25/26/27 map. Step 1 is a no-op and says so.
    The GPIO12 warning is kept as a standing rule rather than an instruction --
    it constrains any future remap even though nothing is on 12 today.
2026-08-24 feat(ai): the camera stays where you left it, and the splits come off disk
    capture.py takes J's version as the base -- camera switching, manual focus,
    pan, grid, fullscreen, resolution request -- and adds persistence on top.
    Every setting is written to ai/capture_settings.json the instant it changes,
    so a crash or an X-closed window still leaves the rig saved. The camera
    remembers nothing across a release(); the file does, and the script re-tells
    the driver on open. Explicit flag beats saved file beats default.
    Gitignored: it describes one physical rig.
    train.py reads ai/dataset/{train,val,test} directly, so validation_split,
    subset and seed are gone along with the take/skip block that carv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
2026-08-24 fix(backend): load .env, and give the classifier a door to knock on
    Two faults, either of which alone stops the hardware path.
    1. NOTHING LOADED backend/.env. No dotenv dependency, no --env-file, no
    loadEnvFile(). So DEVICE_API_KEY was undefined and requireDeviceKey threw
    503 DEVICE_AUTH_NOT_CONFIGURED on every station call -- the board opening an
    inspection, the classifier asking for work, the assessment, the result poll.
    All four. The database connected only by luck: db.js falls back to
    127.0.0.1/3306/root//eggministrator, which happens to match .env exactly.
    GEMINI_API_KEY had no such luck.
    Fixed with node --env-file=.env, native since Node 20.6 and no new
    depend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
    [stub_server.py]
2026-08-24 feat: one script brings the station up, in the order that actually works
    Four processes, and the order is not cosmetic: mysql2 throws on its first
    query if MySQL is down, the listener quietly polls a dead port if the backend
    is down, and the dashboard renders an empty shell if it starts before either.
    Under pressure that is four chances to get it wrong.
    run-eggministrator.bat checks at every step and stops with the failing path and
    the command that fixes it, rather than starting the next thing on top of a
    broken one. Each process gets its own titled window, so a crash is visible at a
    glance and one can be restarted without killing the other three.
    Two steps earn their place beyond saving k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
2026-08-24 fix: the repo was answering an older paper, and it cost a requirement
    Everything here came out of reading Ver9.1 itself instead of the notes made
    against earlier versions. Three separate things were being tracked wrong.
    WEIGHT TOLERANCE: 1 g, not +/-2 g.
    CONTRACT said +/-2 g and every repo document inherited it. Table 9 reads
    "Weight measurement error - Within 1 grams of a reference scale." Only the
    paper is graded, so the project was committed to 1 g regardless; the looser
    figure just meant the build was being calibrated toward a target nobody marks.
    The paper was not touched. Seven sites, all prose and comments, no behaviour.
    Consequence now stated rather than hidden: the 735.25 vs 698.0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
    [EggMinistrator_ESP32.ino, tester.ino]
2026-08-24 feat(dashboard): show the egg without being asked to
    The dashboard loaded once and never again. With eggs placed one at a time in
    front of a panel, the board lights up and the screen sits there unchanged until
    somebody presses refresh. That is the demo, not a detail.
    The obvious fix is to poll /api/inspections. It is also wrong: listInspections()
    has no LIMIT and returns every non-'no_egg' row, which is 5,239 of them on the
    seeded database. Fetching that on a timer moves about a megabyte at a time and
    re-renders every chart on each tick, which is visible jank on stage.
    So the poll asks a new endpoint, GET /api/inspections/revision, which returns
    three numbers, and the full list is refetche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
2026-08-24 feat(ai): the brightness gate, closed in Session 12 and now written
    A candler that has failed does not produce a dim image, it produces a black
    one, and the model does not error on a black image. It picks one of its three
    classes and reports a confidence, because that is the only thing a classifier
    can do.
    This is not hypothetical. On the first end-to-end run of listen_station.py, on
    2026-08-24, the webcam happened to be covered. Mean brightness 0.9 out of 255.
    The system recorded "not_an_egg, confidence 0.385" and moved on. It even looked
    right, which is worse than looking wrong: the model has never seen a dark frame
    in training, so it had no basis for that answer and got there by luck.
    T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
2026-08-25 fix: the board gave up before the verdict arrived
    J saw the dashboard show a verdict while the LCD sat on "No response. Try
    again." and the RGB module never lit. Three symptoms, one cause: the station
    produced the verdict correctly, just outside the window the board was willing
    to wait, so handleResult() never ran and the LEDs never got their turn.
    RESULT_TIMEOUT_MS was 5000, and the pipeline it waits on does not fit:
    * listener poll interval up to 250 ms
    * four stale-frame discards + read 150-500 ms
    * first predict() of the session 1590 ms
    * every predict() after it 120 ms
    * POST assessment about 50 ms
    * the boar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
    [EggMinistrator_ESP32.ino]
2026-08-25 fix: the listener sent raw_result as an object, the API wants the line
    Every inspection came back 400 RAW_RESULT_REQUIRED, repeatedly, with the frame
    already written to disk and the inspection left open to be retried forever:
    inspection 5320: could not report -> POST /api/inspections/5320/assessment
    -> 400 {"error":"raw_result must contain the classifier JSON line exactly as
    emitted.","code":"RAW_RESULT_REQUIRED"}
    raw_result is LONGTEXT and the API stores the classifier's line verbatim, which
    5ab7a15 settled. So parseRawResult() checks hasText() first and only then
    JSON.parse()s it. classify() was building a dict, which serialises to a JSON
    object rather than a string, fails the stri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
2026-08-25 fix: the station framed the egg somewhere the dataset never did
    capture.py saves how the dataset was shot. The listener read one field out of
    it, the zoom, and defaulted the rest. crop_to_zoom() takes an OFF-centre crop,
    so the pan mattered just as much and nobody was passing it.
    On J's rig capture_settings.json holds zoom 2.0, pan_x 20, pan_y -160. At
    1280x720 that is a 640x360 crop, and the two framings do not overlap the way
    anyone assumed:
    dataset was shot at top-left (340, 20)
    station was looking at top-left (320, 180)
    160 px of vertical offset against a 360 px tall crop. Not drift. The training
    images came from the top of the frame and the station was photographing the
    middle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
2026-08-30 feat(dashboard): a mark that matches the palette, and a rail that stops shoving
    The logo was a 2.0 MB 1536x1024 render: a BLUE egg on a baked grey
    gradient, no transparency, in an app whose brand colour is forest green.
    The scale-[2.5] + translate-y hacks at four call sites existed to shove
    that grey background out of a 44px frame. Redrawn as vector -- same mark,
    egg over a bar chart over a checklist -- so it is ~1 KB, sharp at any
    size, and the right colour. Hero re-encoded PNG -> JPEG.
    The rail now overlays instead of pushing, and opens on click instead of
    hover. Pushing meant <main> resized on every frame of a 200ms animation,
    and 23 recharts ResponsiveContainers re-measured each time --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
2026-08-30 feat(dashboard): one green, and numbers that line up
    There were eighteen greens: four forest tokens, six raw hexes and eight
    stock Tailwind steps. The login screen opened onto a sidebar that was a
    different green, three near-identical hexes (#58ad5c, #5cae5e, #5bae60)
    all meant the same thing, and the same values appeared in both #64748B
    and #64748b -- the fingerprint of colour pasted in from different sittings
    rather than chosen once.
    Now one scale, hue 155, derived from #0B5D3B at the 800 step. Every stock
    green-* class is gone. The focus ring joined the scale too.
    Plex Mono on egg IDs, tabular figures on weights and stat values, so the
    columns align instead of drifting. Two static weigh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
2026-08-30 fix(dashboard): give the rail more than one way out
    Opening on click left exactly one way to close it: click the logo again.
    Now navigating, Escape, or a click anywhere outside all collapse it. The
    outside-click uses a document mousedown listener rather than an overlay
    element, so the click still reaches whatever is underneath instead of
    being swallowed just to shut the rail.
    Also removes onFocusCapture from the aside. It fired before the logo
    button's own click, setting expanded=true so the click toggled straight
    back to false -- the two were fighting. The toggle button carries
    aria-expanded and a labelled state, which covers the keyboard case better
    than the focus handler did.
    And the na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
2026-09-01 feat(dashboard): six names in order, and one spelling
    The size palette was teal, sky, amber, orange, violet and rose. Six
    unrelated hues for data that has an order the names already state, with
    Medium landing on the same amber the app uses to mean "look at this".
    Now one warm low-chroma `grade` ramp, Pewee to Jumbo light to dark, one
    shared ink colour so the column reads as a scale.
    Warm rather than cool because the page ground is cream and a cool badge
    sits off it. Low chroma because warm is already this app's warning
    family -- there is a token named `warning`, and the amber "overridden"
    pill sits in the same History row as the size badge. Green and red are
    taken by the verdict, so the ove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
2026-09-01 feat(dashboard): a cracked egg, in a tone neither ground can eat
    Replaces the outlined shell holding three bars, a tick and two rows.
    That mark was a chart wearing an egg costume: at 28px in the sidebar the
    bars closed up and it read as a smudge.
    The new mark is a cracked egg -- a zigzag break line, shell below it,
    yolk above -- which is legible at rail size and is the thing the machine
    actually looks inside.
    The shell is a mid tan, and that is the whole colour decision. One
    logo.svg is imported in three places and two of them are dark: the
    sidebar gradient and the login header over its hero photo. The third,
    the mobile top bar, is light. Brand green dissolves into the sidebar and
    eggshell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
2026-09-01 docs: stop narrating the past, and say the enclosure is being rebuilt
    Two jobs. The docs had been carrying their own changelog in blockquotes
    -- "this used to say X", "corrected on date Y" -- and git already has
    all of it. Teammates read the paper, not the repo, so the audience for
    that history was one person who has better tools for it.
    Every blockquote that narrated a change is deleted. Every one that
    stated a live constraint is unwrapped into plain text and kept: do not
    re-add spots, balut is out of scope by input, the BOM must match the
    paper, staff_overrides is provisioned but unused. 147 quoted lines down
    to 2, and the 2 left are the operator's grading list quoted verbatim,
    which is a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
    [stub_server.py]
2026-09-02 docs: the tray has a weight budget, and the board loop has an unloading state
    Two things M asked while reading the fan-out spec, neither of which the
    spec covers on purpose.
    The cell is 1 kg and six Jumbo eggs are about 480 g, so the tray that
    rests on it has to stay under 300 g. The overload risk is not the eggs,
    it is a hand pressing down while seating one; a mechanical stop under
    the tray takes that load instead of the beam. Only the tray touches the
    cell. The lid must not brush it, because lid-close is the capture
    trigger.
    The firmware's settle is a fixed delay plus an average, which averages a
    resting hand straight in. v2 needs a stability gate, bounds on each
    step, a re-tare against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
2026-09-02 docs(hardware): cintra, horizontal and a hinge, and nothing to cut against yet
    Three decisions were relayed verbally on 2026-09-02 and existed nowhere: the
    eggs lie horizontal, the material is cintra, and the lid gets a hinge. All
    three are recorded here.
    Two of them carry consequences nobody had written down. Cintra supersedes the
    2026-08-28 "woodwork" ruling that a secured woodworker was hired against, so
    item 6 is being re-costed a second time and the team should confirm it meant to
    replace wood rather than only to rule out printing. The hinge fixes the
    camera's arc, which means camera-to-tray distance is now set by hinge geometry
    and the lid has to close repeatably; it also needs the li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
2026-09-02 docs(hardware): the box is measured off the internals, not cut to a drawing
    The team chose build-first on 2026-09-02: assemble the internals, then size the
    enclosure around them, rather than pre-cutting a pocket per part. R and J both
    pushed back on pre-measuring components and both were right. R's own
    prototype.FCStd is the argument for it, having reserved space for a bare ESP32
    module when the team owns a devkit at roughly twice the footprint.
    So the per-component measuring list is dropped. No calipers on circuit boards,
    no pre-measuring the TFT, breadboard, HX711, hinge or webcam body.
    What stays is only what assembling and looking cannot tell you. Egg width,
    because the tray is an inte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
2026-09-02 docs: the woodworker was deferred, so the team cuts cintra themselves
    The clash flagged earlier between the 2026-08-28 "woodwork" ruling and the
    2026-09-02 cintra decision was not a clash. The woodworker route was deferred,
    so wood fell with the outsourced build it assumed rather than being overruled on
    its merits, and R, J and D now cut and assemble the box in-house. Cintra is what
    an in-house team can work.
    That changes what item 6 costs, not just what it is made of. It prices as sheet
    material plus fasteners rather than as a commissioned build, and the two figures
    are nowhere near each other. Item 6 is the largest single line in the parts bill,
    so it moves Table 2, Table 6 and Table 15 i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
2026-09-02 docs: walk back the blueprint authorship, and log R's touchscreen idea
    An earlier pass through these files asserted the version 2 blueprint was M's
    drawing and not R's. That was wrong to state as fact. Section 9's wording,
    "hand-drawn on paper and described verbally by M", never said who held the pen,
    and M's own recollection is the reverse and is hedged. Every place that claimed
    an author now says authorship is unverified and points at R for the drawing,
    because asking the wrong person for it is the only thing the ambiguity actually
    costs.
    Logs R's idea of triggering capture from a touch on the TFT rather than a
    lid-close switch, as thinking rather than decided, with the objection to put t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
2026-09-02 test(backend): the route test no longer waits eight seconds for a timer that already fired
2026-09-02 feat(firmware): a tray can be simulated end to end before the enclosure exists
2026-09-02 feat(ai): the camera answers which holes are full, and refuses a tray loaded out of order
2026-09-02 feat(ai): a lid-close frame can be built from the dataset, with its answer key
2026-09-02 feat(ai): one frame becomes six verdicts, or a refusal, or a wait for the light
